EEST1/Entrenador_2023/shild_1/Documentacion/Captura desde 2023-02-04 18-30-01.png

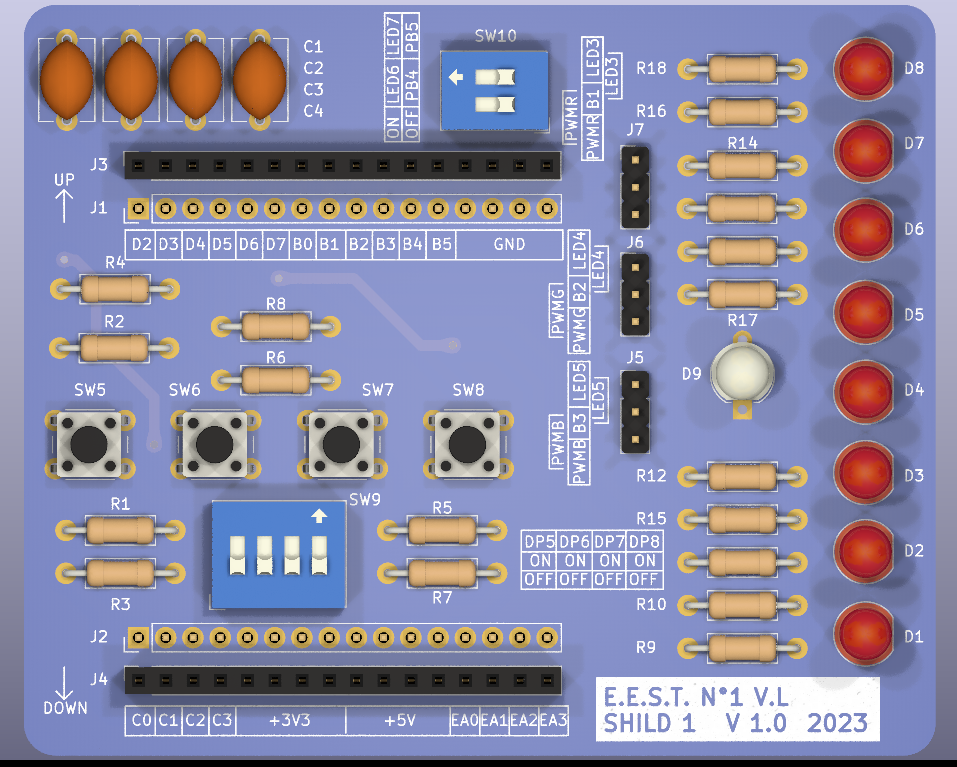
shild_1/Documentacion/Captura desde 2023-02-04 18-30-01.png
