EEST1/Entrenador_2023/placa_base/Placa_base_2layers/Documentacion/Captura desde 2023-01-20 19-26-29.png

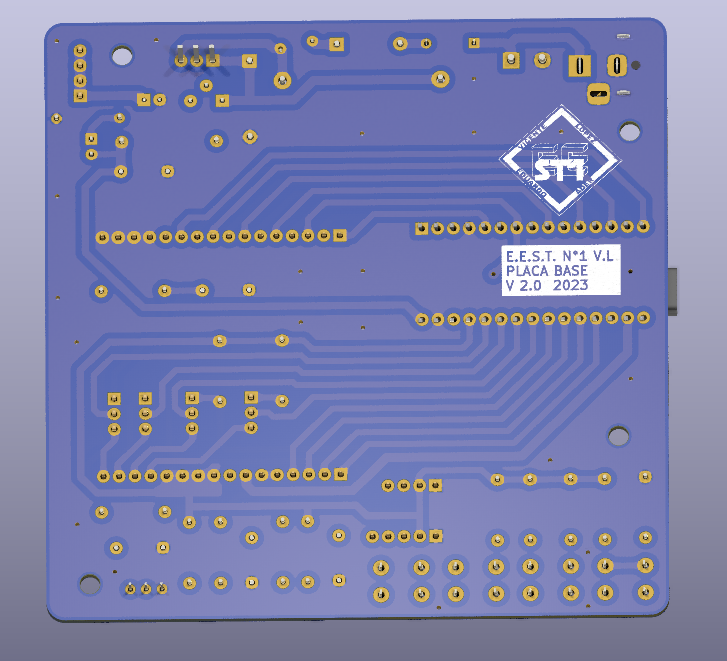
placa_base/Placa_base_2layers/Documentacion/Captura desde 2023-01-20 19-26-29.png
