EEST1/Entrenador_2023/shild_1/Documentacion/shild_1_buck.jpg

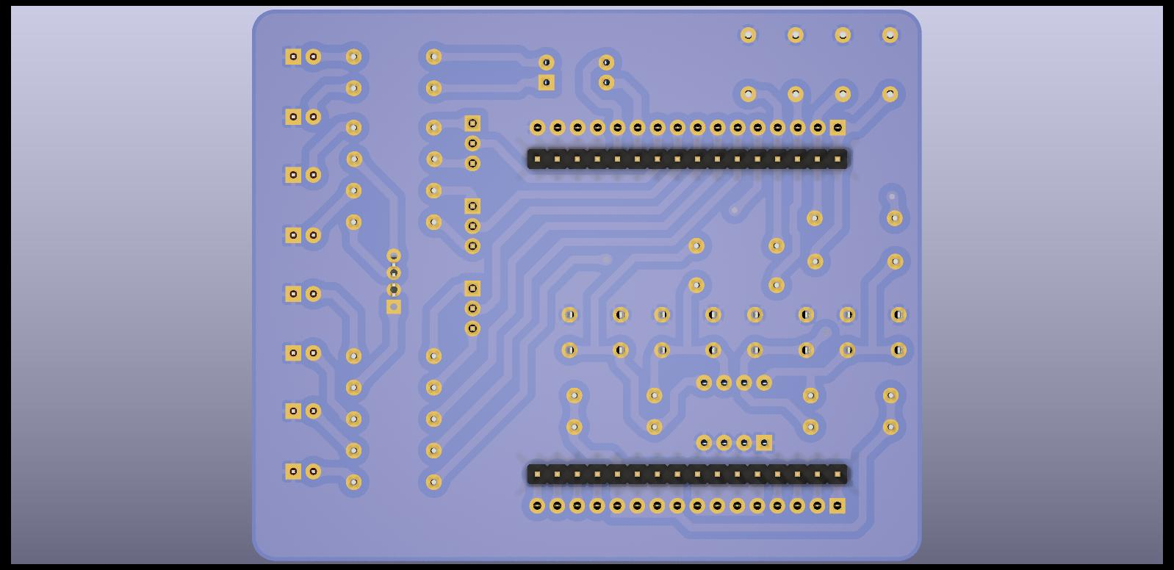
shild_1/Documentacion/shild_1_buck.jpg
