EEST1/Entrenador_2023/shild_1/fabrication/step/Placa_base.step

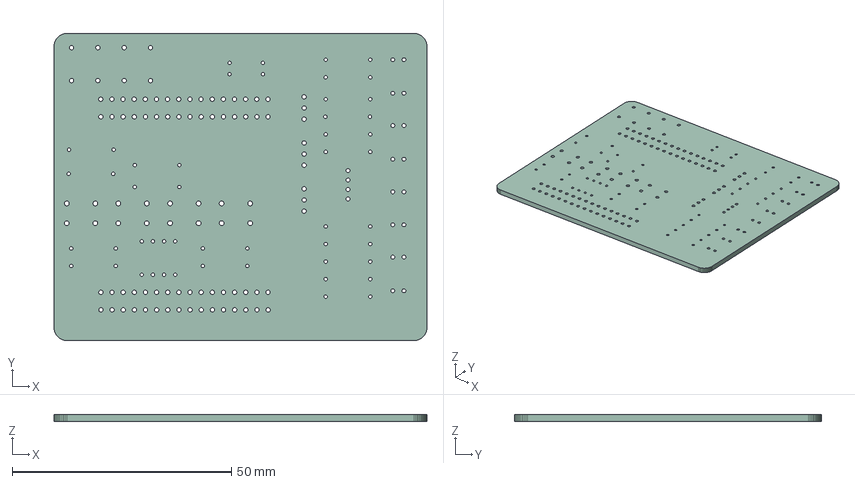
[picture p7: CAD file, 2023-05-10]
shild_1/fabrication/step/Placa_base.step
85.0 x 70.0 x 1.58 mm
