EEST1/Entrenador_2023/shild_1/Documentacion/shild_1.pdf

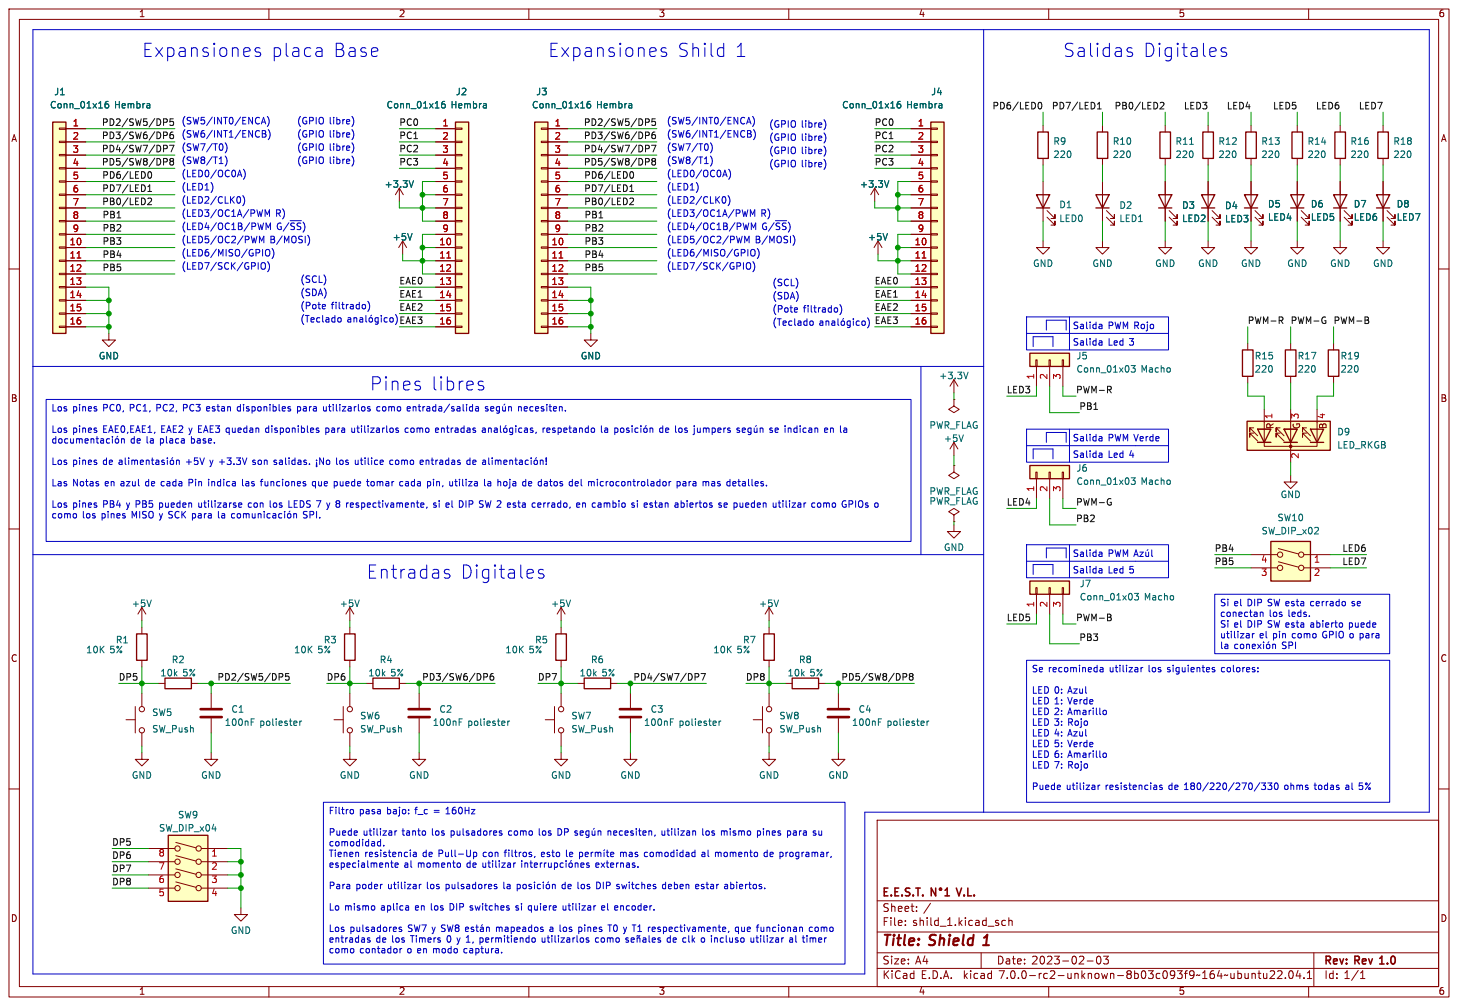
[picture p8: page 1]

conectan los leds. Si el DIP SW esta abierto puede

LED 2: Amarillo
LED 3: Rojo
LED 4: Azul LED 5: Verde
