EEST1/Entrenador_2023/shild_2/Documentacion/shild_2.pdf

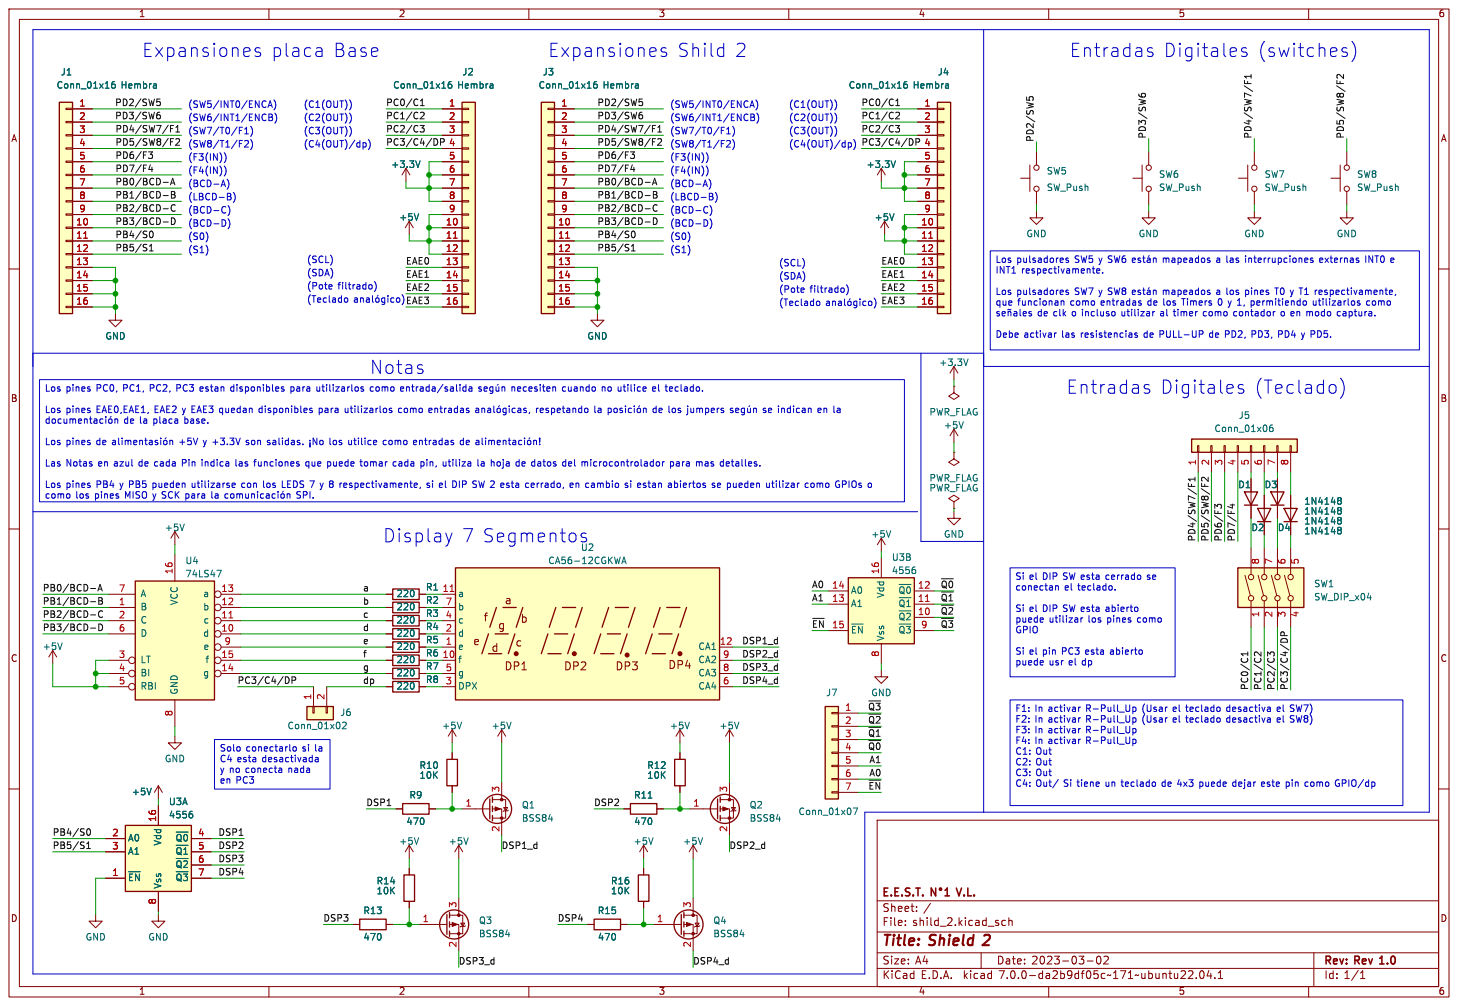
[picture p9: page 1]

conectan el teclado. Si el DIP SW esta abierto

Si el pin PC3 esta abierto
