EEST1/Entrenador_2023/placa_base/Placa_base_2layers/Documentacion/Placa_base.pdf

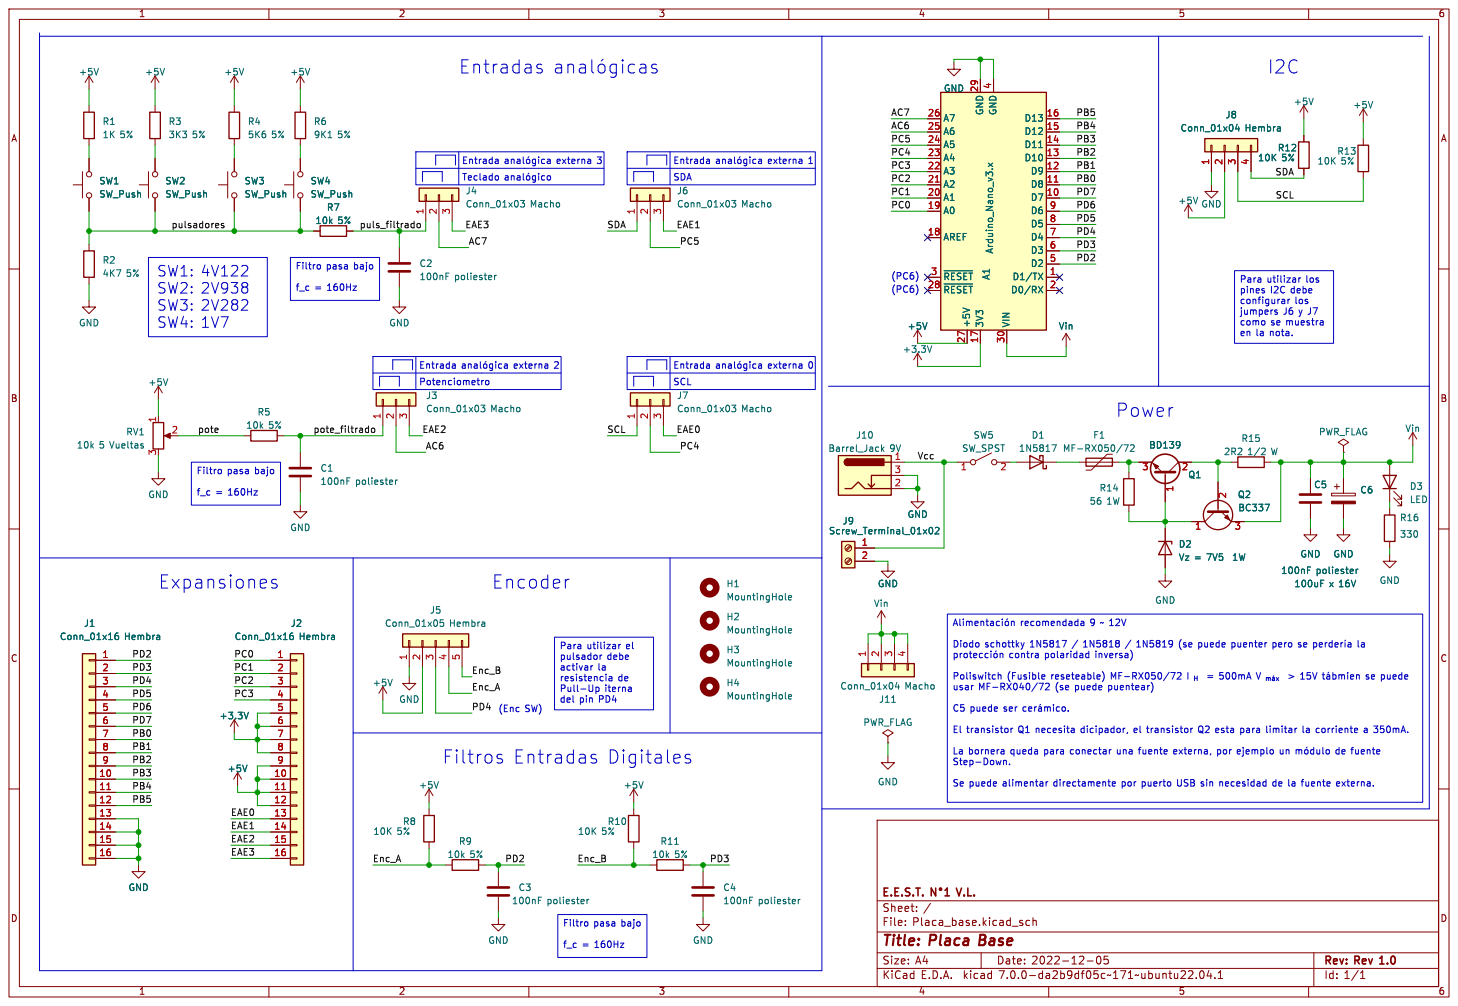
[picture p10: page 1]

Entrada þÿanalógica externa 3 Teclado þÿanalógico Entrada þÿanalógica externa 2 Entradas þÿanalógicas

Entrada þÿanalógica externa 1 SDA

Id: 1/1 Title: Placa Base
