EEST1/Entrenador_2023/placa_base/Draft1.asc

C1: cap; 100n
C2: cap; 100n
C3: cap; 100n
C4: cap; 100n
R1: res; 10k
R2: res; 10k
R4: res; 10k
R5: res; 10k
R6: res; 10k
R7: res; 10k
V1: voltage; ""; AC 1 0
V2: voltage; 5; Rser=0
V3: voltage; ""; AC 1 0
V4: voltage; ""; AC 1 0
V5: voltage; ""; AC 1 0
Named nets: 0, Vcc, out1, out2, out3, out4
.ac dec 1000 0.01 10Meg
