EEST1/Entrenador_2023/shild_2/Documentacion/pmos.asc

D1: LED; AOT-2015
M1: pmos; BSS84
R1: res; 470
R2: res; 10k
R3: res; 33
V1: voltage; PULSE(0 5 0 0.1 0.1 2 4 2)
V2: voltage; 5; Rser=0
Named nets: 0, Vcc
.tran 0 8 0 10m
