EEST1/Entrenador_2023/placa_base/Placa_base_2layers/Documentacion/fuebte.asc

D1: zener; EDZV7_5B
Q1: npn; BD139
Q2: npn; BC337-40
R1: res; 20
R2: res; 56
R3: res; 2.2
V2: voltage; SINE(10.5 1.5 1 0 0 0 6)
Named nets: 0
.tran 0 6 0 1m
