EEST1/Entrenador_2023/placa_base/Placa_base_2layers/Documentacion/fuebte_zener.asc

D1: zener; EDZV6_8B
R1: res; 20
R2: res; 6.2
V2: voltage; SINE(10.5 1.5 1 0 0 0 6)
Named nets: 0
.tran 0 6 0 1m
