EEST1/Entrenador_2023/placa_base/Placa_base_2layers/Placa_base.kicad_pcb

## KiCad design placa_base/Placa_base_2layers/Placa_base.kicad_pcb (2023-05-21)

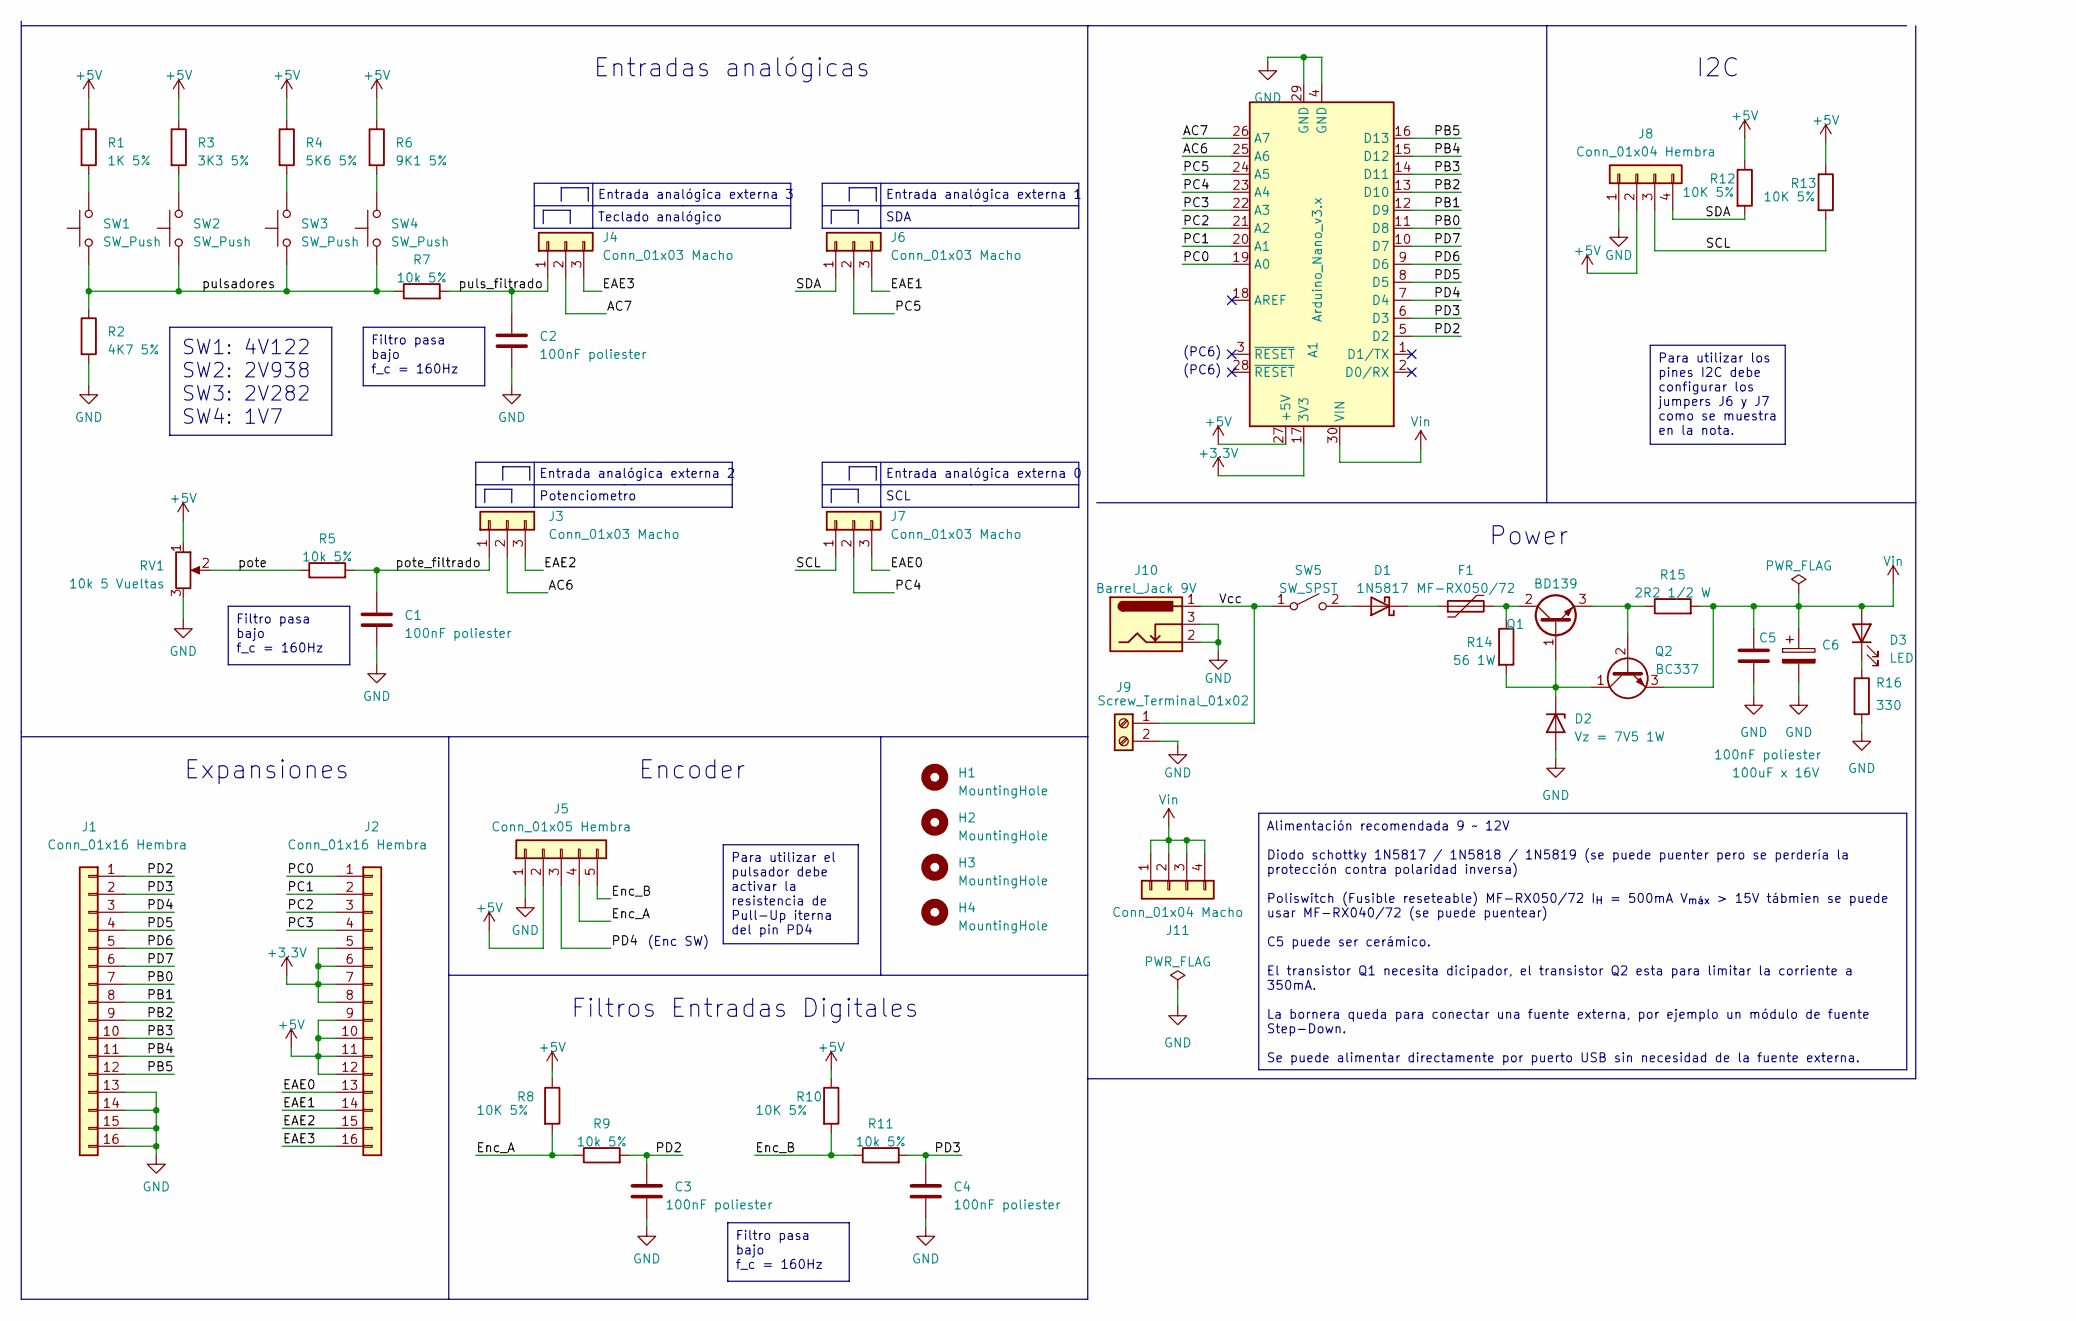
[picture p11: schematic Placa_base.kicad_sch, Placa Base]

Parts:
A1: Arduino_Nano_v3.x; Arduino_Nano
C1, C2, C3, C4, C5: 100nF poliester; C_Disc_D7.5mm_W5.0mm_P7.50mm
C6: 100uF x 16V; CP_Radial_D8.0mm_P3.50mm
D1: 1N5817; D_DO-41_SOD81_P10.16mm_Horizontal
D2: Vz = 7V5 1W; D_DO-41_SOD81_P12.70mm_Horizontal
D3: LED; LED_D3.0mm
F1: MF-RX050/72; Fuse_Bourns_MF-RHT050
H1, H2, H3, H4: MountingHole; MountingHole_3.2mm_M3
J1, J2: Conn_01x16 Hembra; PinSocket_1x16_P2.54mm_Vertical
J3, J4, J6, J7: Conn_01x03 Macho; PinHeader_1x03_P2.54mm_Vertical
J5: Conn_01x05 Hembra; PinSocket_1x05_P2.54mm_Vertical
J8: Conn_01x04 Hembra; PinSocket_1x04_P2.54mm_Vertical
J9: Screw_Terminal_01x02; TerminalBlock_Phoenix_PT-1,5-2-5.0-H_1x02_P5.00mm_Horizontal
J10: Barrel_Jack 9V; BarrelJack_Horizontal
J11: Conn_01x04 Macho; PinHeader_1x04_P2.54mm_Vertical
Q1: BD139; TO-126-3_Vertical
Q2: BC337; TO-92L_Wide
R1: 1K 5%; R_Axial_DIN0207_L6.3mm_D2.5mm_P10.16mm_Horizontal
R2: 4K7 5%; R_Axial_DIN0207_L6.3mm_D2.5mm_P10.16mm_Horizontal
R3: 3K3 5%; R_Axial_DIN0207_L6.3mm_D2.5mm_P10.16mm_Horizontal
R4: 5K6 5%; R_Axial_DIN0207_L6.3mm_D2.5mm_P10.16mm_Horizontal
R5, R7, R9, R11: 10k 5%; R_Axial_DIN0207_L6.3mm_D2.5mm_P10.16mm_Horizontal
R6: 9K1 5%; R_Axial_DIN0207_L6.3mm_D2.5mm_P10.16mm_Horizontal
R8, R10, R12, R13: 10K 5%; R_Axial_DIN0207_L6.3mm_D2.5mm_P10.16mm_Horizontal
R14: 56 1W; R_Axial_DIN0614_L14.3mm_D5.7mm_P25.40mm_Horizontal
R15: 2R2 1/2 W; R_Axial_DIN0309_L9.0mm_D3.2mm_P15.24mm_Horizontal
R16: 330; R_Axial_DIN0207_L6.3mm_D2.5mm_P10.16mm_Horizontal
RV1: 10k 5 Vueltas; Potentiometer_Bourns_3266Y_Vertical
SW1, SW2, SW3, SW4: SW_Push; SW_PUSH_6mm_H8mm
SW5: SW_SPST; SW_DIP_SPSTx01_Slide_9.78x4.72mm_W7.62mm_P2.54mm

Connections:
+3.3V: A1.17 (3V3), J2.5, J2.6, J2.7, J2.8
+5V: A1.27 (+5V), J2.9, J2.10, J2.11, J2.12, J5.2, J8.2, R1.1, R3.1, R4.1, R6.1, R8.1, R10.1, R12.1, R13.1, RV1.1
/AC6: A1.25 (A6), J3.2
/AC7: A1.26 (A7), J4.2
/EAE0: J2.13, J7.3
/EAE1: J2.14, J6.3
/EAE2: J2.15, J3.3
/EAE3: J2.16, J4.3
/Enc_A: J5.4, R8.2, R9.1
/Enc_B: J5.5, R10.2, R11.1
/PB0: A1.11 (D8), J1.7
/PB1: A1.12 (D9), J1.8
/PB2: A1.13 (D10), J1.9
/PB3: A1.14 (D11), J1.10
/PB4: A1.15 (D12), J1.11
/PB5: A1.16 (D13), J1.12
/PC0: A1.19 (A0), J2.1
/PC1: A1.20 (A1), J2.2
/PC2: A1.21 (A2), J2.3
/PC3: A1.22 (A3), J2.4
/PC4: A1.23 (A4), J7.2
/PC5: A1.24 (A5), J6.2
/PD2: A1.5 (D2), C3.1, J1.1, R9.2
/PD3: A1.6 (D3), C4.1, J1.2, R11.2
/PD4: A1.7 (D4), J1.3, J5.3
/PD5: A1.8 (D5), J1.4
/PD6: A1.9 (D6), J1.5
/PD7: A1.10 (D7), J1.6
/SCL: J7.1, J8.3, R13.2
/SDA: J6.1, J8.4, R12.2
/Vcc: J9.1, J10.1, SW5.1 (A)
/pote: R5.1, RV1.2
/pote_filtrado: C1.1, J3.1, R5.2
/puls_filtrado: C2.1, J4.1, R7.2
/pulsadores: R2.1, R7.1, SW1.1, SW2.1, SW3.1, SW4.1
GND: A1.4 (GND), A1.29 (GND), C1.2, C2.2, C3.2, C4.2, C5.2, C6.2, D2.2 (A), J1.13, J1.14, J1.15, J1.16, J5.1, J8.1, J9.2, J10.2, J10.3, R2.2, R16.2, RV1.3
unnamed: D1.2 (A), SW5.2 (B)
unnamed: D1.1 (K), F1.1
unnamed: D2.1 (K), Q1.1 (B), Q2.1 (C), R14.2
unnamed: D3.1 (K), R16.1
unnamed: F1.2, Q1.2 (C), R14.1
unnamed: Q1.3 (E), Q2.2 (B), R15.1
unnamed: R1.2, SW1.2
unnamed: R3.2, SW2.2
unnamed: R4.2, SW3.2
unnamed: R6.2, SW4.2
Vin: A1.30 (VIN), C5.1, C6.1, D3.2 (A), J11.1, J11.2, J11.3, J11.4, Q2.3 (E), R15.2

Notes on the sheet:
Filtro pasa bajo f_c = 160Hz
SW1: 4V122 SW2: 2V938 SW3: 2V282 SW4: 1V7
Alimentación recomendada 9 ~ 12V Diodo schottky 1N5817 / 1N5818 / 1N5819 (se puede puenter pero se perdería la protección contra polaridad inversa) Poliswitch (Fusible reseteable) MF-RX050/72 I_{H} = 500mA V_{máx} > 15V tábmien se puede usar MF-RX040/72 (se puede puentear) C5 puede ser cerámico. El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
Para utilizar el pulsador debe activar la resistencia de Pull-Up iterna del pin PD4
Para utilizar los pines I2C debe configurar los jumpers J6 y J7 como se muestra en la nota.
Entrada analógica externa 0
Entrada analógica externa 1
SCL
(PC6)
Encoder
Power
Entrada analógica externa 2
SDA
I2C
Filtros Entradas Digitales
Entrada analógica externa 3
Expansiones
Teclado analógico
(Enc SW)
Entradas analógicas
Potenciometro

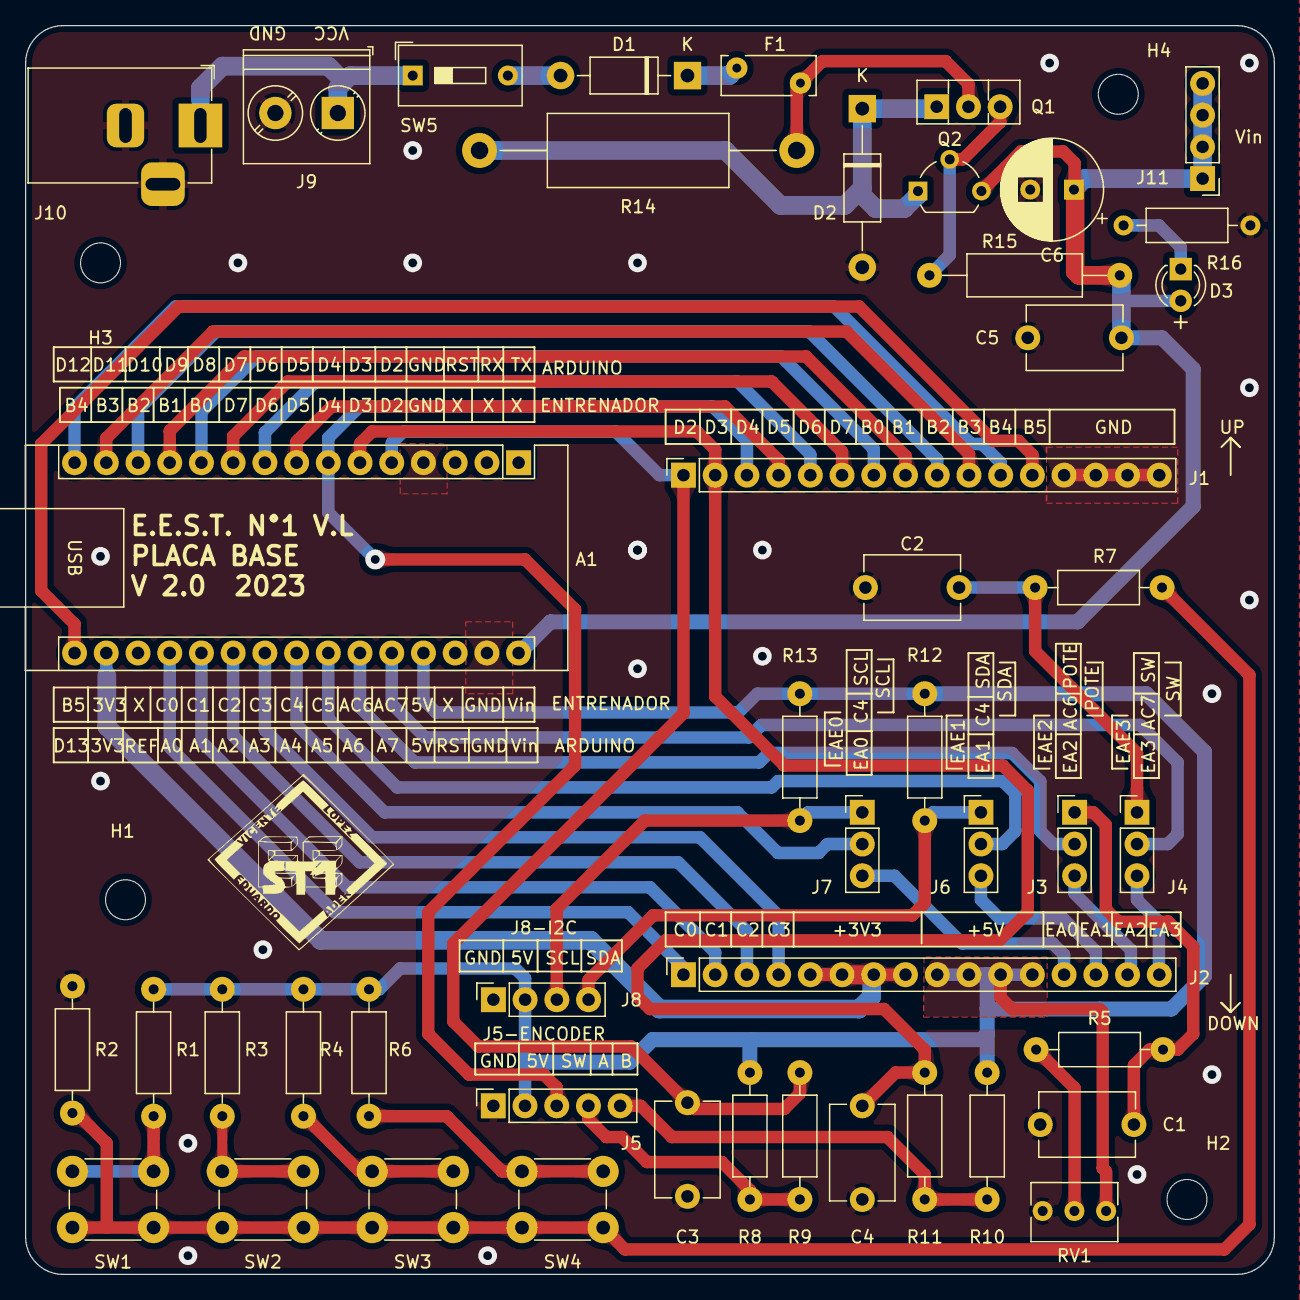
[picture p12: board Placa_base.kicad_pcb from above]

Board: 2 copper layers, 100.0 x 100.0 mm, 50 parts (0 on the bottom side), 47 nets.
