EEST1/Entrenador_2023/shild_2/shild_2.kicad_pcb

## KiCad design shild_2/shild_2.kicad_pcb (2023-05-10)

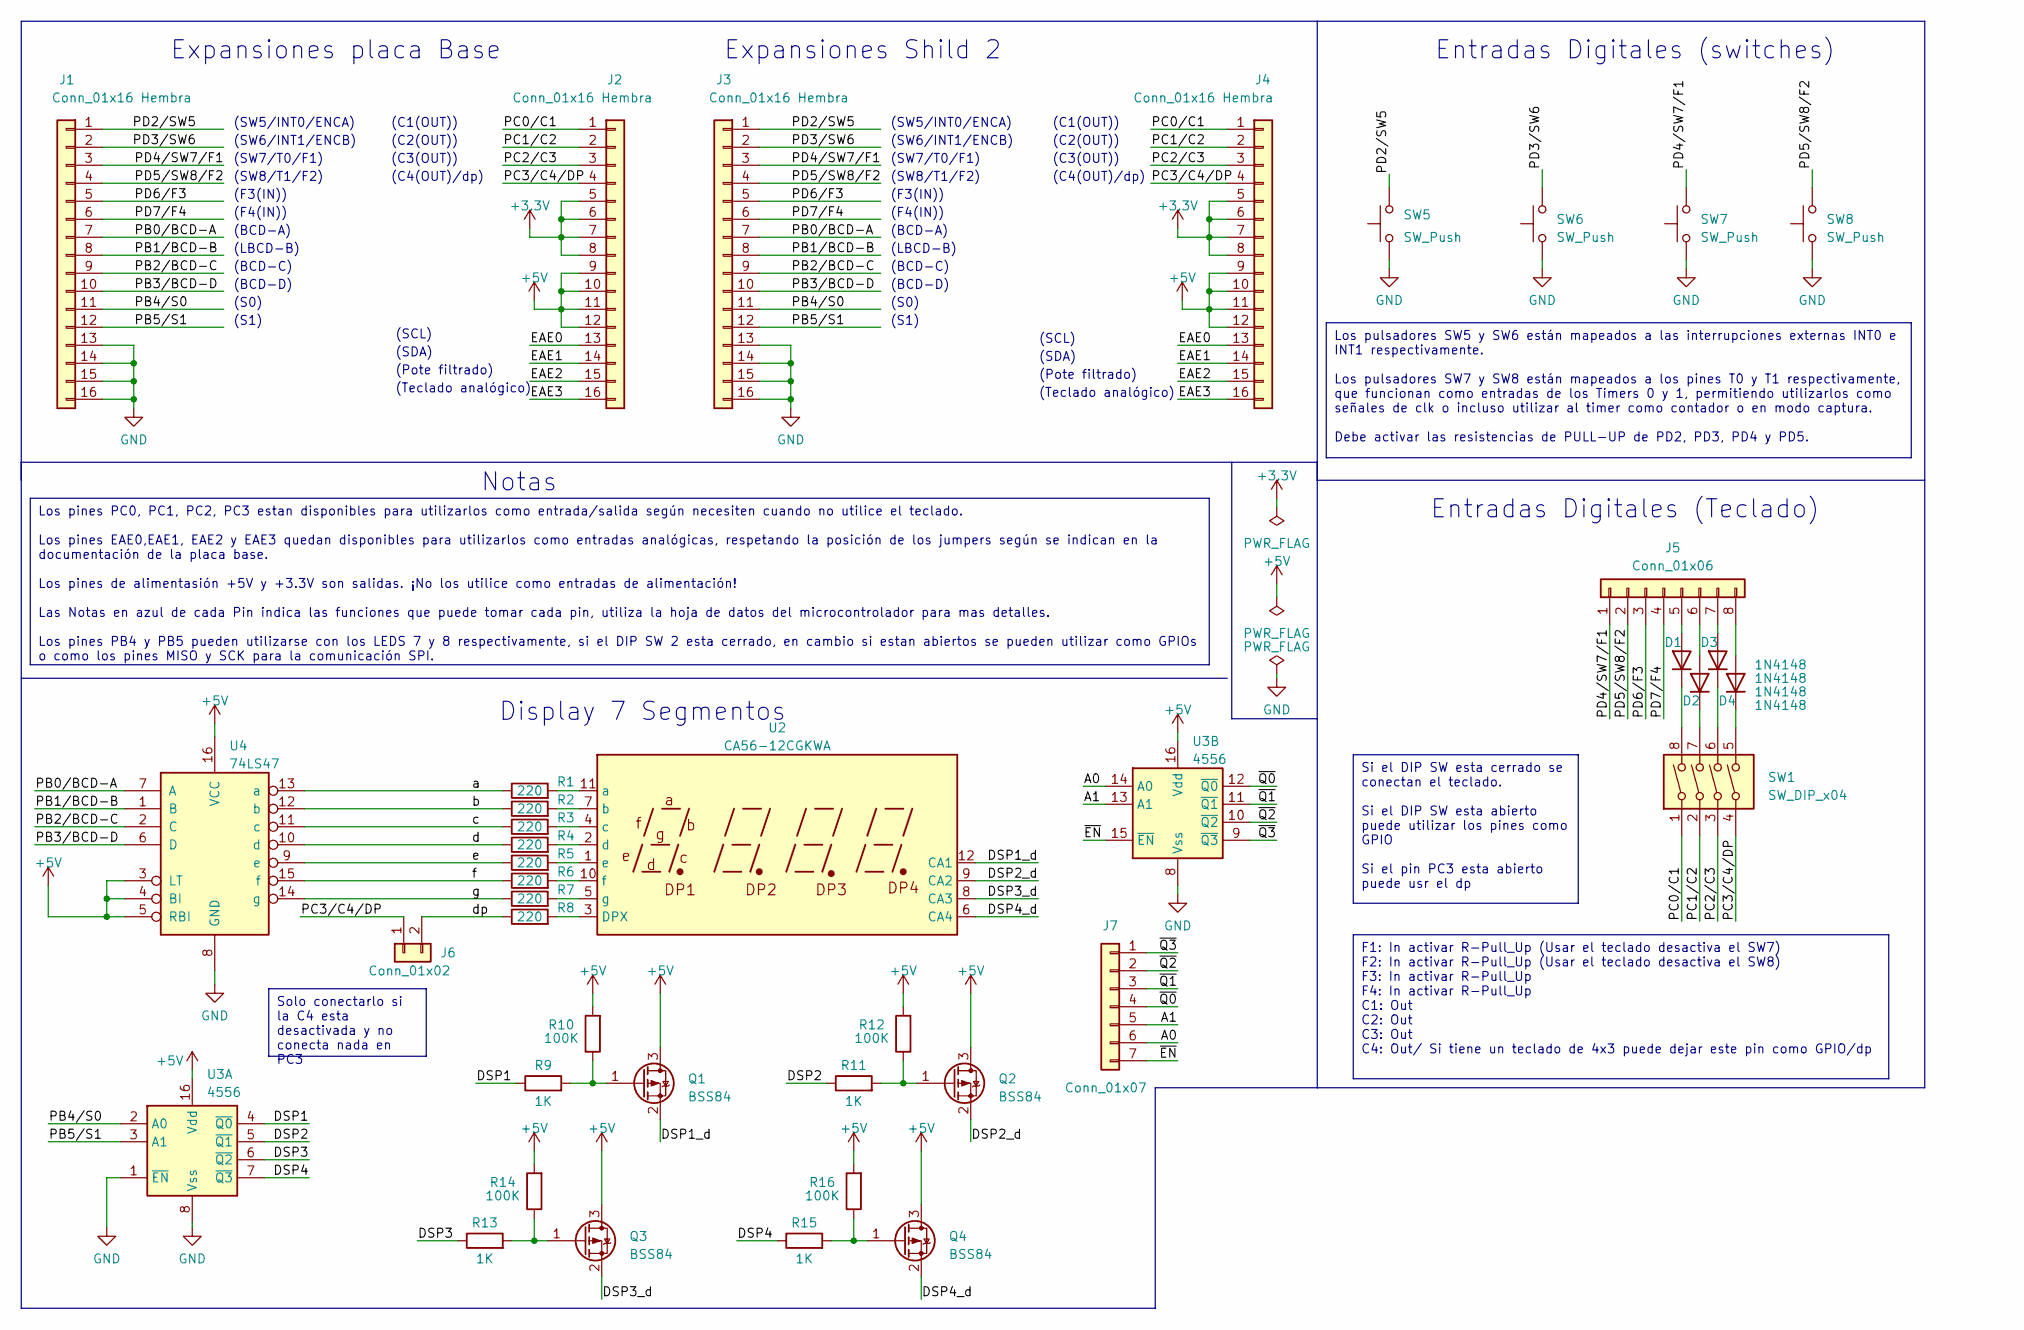
[picture p13: schematic shild_2.kicad_sch, Shield 2]

Parts:
D1, D2, D3, D4: 1N4148; D_DO-35_SOD27_P12.70mm_Horizontal
J1, J2: Conn_01x16 Hembra; PinHeader_1x16_P2.54mm_Vertical
J3, J4: Conn_01x16 Hembra; PinSocket_1x16_P2.54mm_Vertical
J5: Conn_01x06; PinHeader_1x08_P2.54mm_Vertical
J6: Conn_01x02; PinHeader_1x02_P2.54mm_Vertical
J7: Conn_01x07; PinHeader_1x07_P2.54mm_Vertical
Q1, Q2, Q3, Q4: BSS84; SOT-23
R1, R2, R3, R4, R5, R6, R7, R8: 220; R_Axial_DIN0309_L9.0mm_D3.2mm_P12.70mm_Horizontal
R9, R11, R13, R15: 1K; R_1206_3216Metric_Pad1.30x1.75mm_HandSolder
R10, R12, R14, R16: 100K; R_1206_3216Metric_Pad1.30x1.75mm_HandSolder
SW1: SW_DIP_x04; SW_DIP_SPSTx04_Slide_9.78x12.34mm_W7.62mm_P2.54mm
SW5, SW6, SW7, SW8: SW_Push; SW_PUSH_6mm_H8mm
U2: CA56-12CGKWA
U3: 4556; DIP-16_W7.62mm_LongPads
U4: 74LS47; DIP-16_W7.62mm_LongPads

Connections:
+3.3V: J2.5, J2.6, J2.7, J2.8, J4.5, J4.6, J4.7, J4.8
+5V: J2.9, J2.10, J2.11, J2.12, J4.9, J4.10, J4.11, J4.12, Q1.3 (D), Q2.3 (D), Q3.3 (D), Q4.3 (D), R10.2, R12.2, R14.2, R16.2, U3.16 (Vdd), U4.3 (LT), U4.4 (BI), U4.5 (RBI), U4.16 (VCC)
/A0: J7.6, U3.14 (A0)
/A1: J7.5, U3.13 (A1)
/DSP1: R9.1, U3.4 (~Q0)
/DSP1_d: Q1.2 (S), U2.12 (CA1)
/DSP2: R11.1, U3.5 (~Q1)
/DSP2_d: Q2.2 (S), U2.9 (CA2)
/DSP3: R13.1, U3.6 (~Q2)
/DSP3_d: Q3.2 (S), U2.8 (CA3)
/DSP4: R15.1, U3.7 (~Q3)
/DSP4_d: Q4.2 (S), U2.6 (CA4)
/EAE0: J2.13, J4.13
/EAE1: J2.14, J4.14
/EAE2: J2.15, J4.15
/EAE3: J2.16, J4.16
/PB0/BCD-A: J1.7, J3.7, U4.7 (A)
/PB1/BCD-B: J1.8, J3.8, U4.1 (B)
/PB2/BCD-C: J1.9, J3.9, U4.2 (C)
/PB3/BCD-D: J1.10, J3.10, U4.6 (D)
/PB4/S0: J1.11, J3.11, U3.2 (A0)
/PB5/S1: J1.12, J3.12, U3.3 (A1)
/PC0/C1: J2.1, J4.1, SW1.1
/PC1/C2: J2.2, J4.2, SW1.2
/PC2/C3: J2.3, J4.3, SW1.3
/PC3/C4/DP: J2.4, J4.4, J6.1, SW1.4
/PD2/SW5: J1.1, J3.1, SW5.2
/PD3/SW6: J1.2, J3.2, SW6.2
/PD4/SW7/F1: J1.3, J3.3, J5.1, SW7.2
/PD5/SW8/F2: J1.4, J3.4, J5.2, SW8.2
/PD6/F3: J1.5, J3.5, J5.3
/PD7/F4: J1.6, J3.6, J5.4
/a: R1.1, U4.13 (a)
/b: R2.1, U4.12 (b)
/c: R3.1, U4.11 (c)
/d: R4.1, U4.10 (d)
/dp: J6.2, R8.1
/e: R5.1, U4.9 (e)
/f: R6.1, U4.15 (f)
/g: R7.1, U4.14 (g)
/~EN: J7.7, U3.15 (~EN)
/~Q0: J7.4, U3.12 (~Q0)
/~Q1: J7.3, U3.11 (~Q1)
/~Q2: J7.2, U3.10 (~Q2)
/~Q3: J7.1, U3.9 (~Q3)
GND: J1.13, J1.14, J1.15, J1.16, J3.13, J3.14, J3.15, J3.16, SW5.1, SW6.1, SW7.1, SW8.1, U3.1 (~EN), U3.8 (Vss), U4.8 (GND)
unnamed: D1.2 (A), J5.5
unnamed: D1.1 (K), SW1.8
unnamed: D2.2 (A), J5.6
unnamed: D2.1 (K), SW1.7
unnamed: D3.2 (A), J5.7
unnamed: D3.1 (K), SW1.6
unnamed: D4.2 (A), J5.8
unnamed: D4.1 (K), SW1.5
unnamed: Q1.1 (G), R9.2, R10.1
unnamed: Q2.1 (G), R11.2, R12.1
unnamed: Q3.1 (G), R13.2, R14.1
unnamed: Q4.1 (G), R15.2, R16.1
unnamed: R8.2, U2.3 (DPX)
unnamed: R1.2, U2.11 (a)
unnamed: R2.2, U2.7 (b)
unnamed: R3.2, U2.4 (c)
unnamed: R4.2, U2.2 (d)
unnamed: R5.2, U2.1 (e)
unnamed: R6.2, U2.10 (f)
unnamed: R7.2, U2.5 (g)

Notes on the sheet:
Si el DIP SW esta cerrado se conectan el teclado. Si el DIP SW esta abierto puede utilizar los pines como GPIO Si el pin PC3 esta abierto puede usr el dp
Los pines PC0, PC1, PC2, PC3 estan disponibles para utilizarlos como entrada/salida según necesiten cuando no utilice el teclado. Los pines EAE0,EAE1, EAE2 y EAE3 quedan disponibles para utilizarlos como entradas analógicas, respetando la posición de los jumpers según se indican en la documentación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
Los pulsadores SW5 y SW6 están mapeados a las interrupciones externas INT0 e INT1 respectivamente. Los pulsadores SW7 y SW8 están mapeados a los pines T0 y T1 respectivamente, que funcionan como entradas de los Timers 0 y 1, permitiendo utilizarlos como señales de clk o incluso utilizar al timer co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
F1: In activar R-Pull_Up (Usar el teclado desactiva el SW7) F2: In activar R-Pull_Up (Usar el teclado desactiva el SW8) F3: In activar R-Pull_Up F4: In activar R-Pull_Up C1: Out C2: Out C3: Out C4: Out/ Si tiene un teclado de 4x3 puede dejar este pin como GPIO/dp
Solo conectarlo si la C4 esta desactivada y no conecta nada en PC3
(SW6/INT1/ENCB)
(F4(IN))
(C2(OUT))
(SW5/INT0/ENCA)
(SW7/T0/F1)
(SDA)
(Teclado analógico)
(SCL)
(S0)
(BCD-A)
(C3(OUT))
(LBCD-B)
Expansiones Shild 2
(F3(IN))
(Pote filtrado)
Entradas Digitales (Teclado)
(C4(OUT)/dp)
(SW8/T1/F2)
(C1(OUT))
Notas
Display 7 Segmentos
(S1)
Expansiones placa Base
Entradas Digitales (switches)
(BCD-C)
(BCD-D)

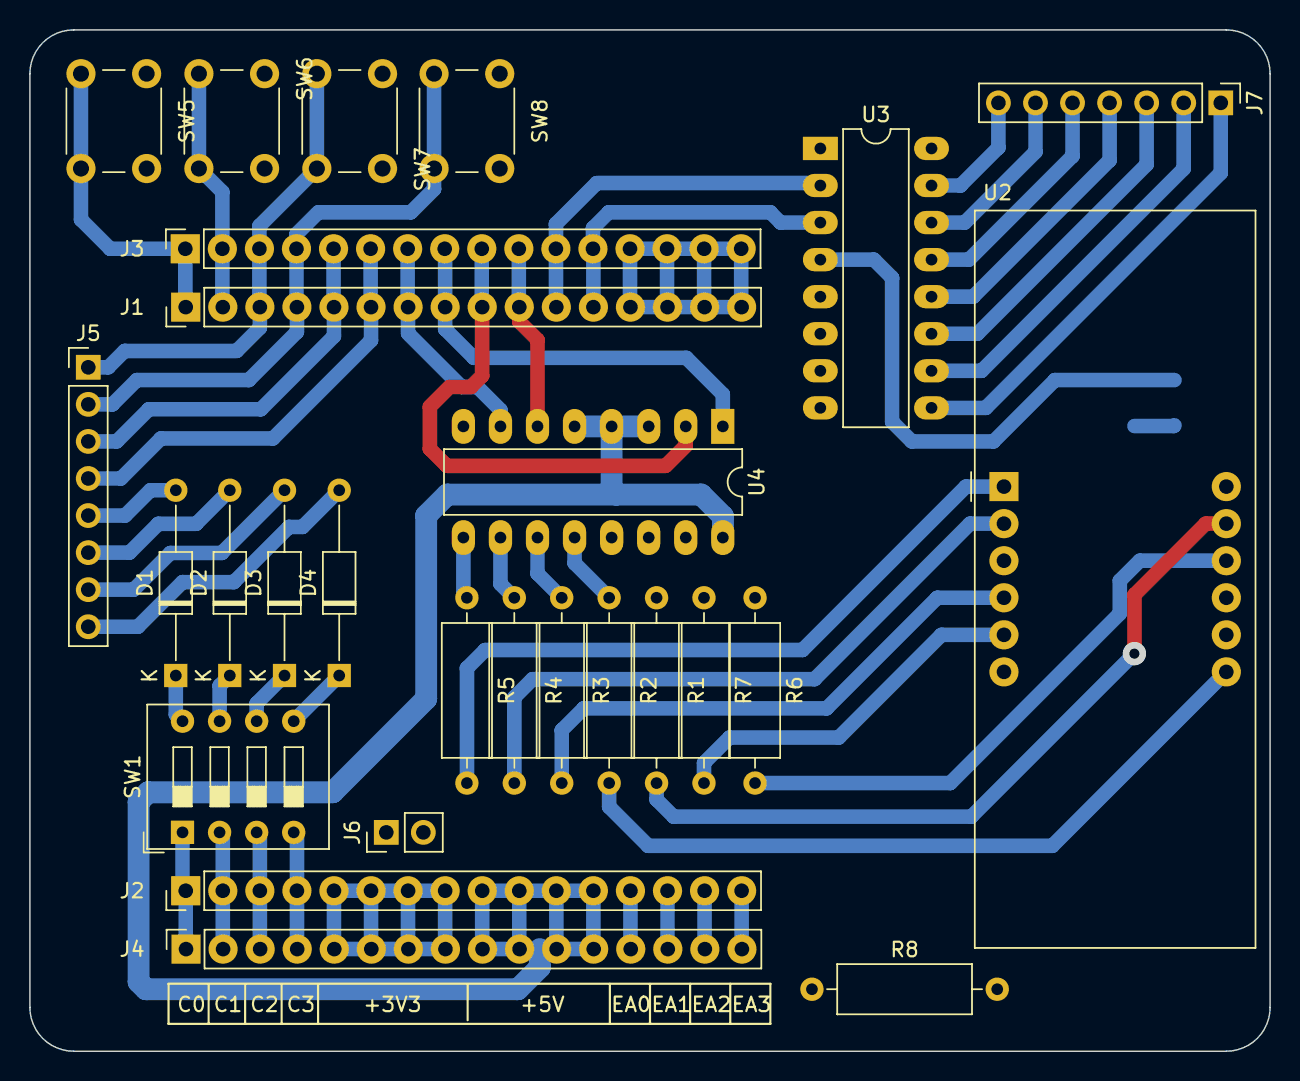
[picture p14: board shild_2.kicad_pcb from above]

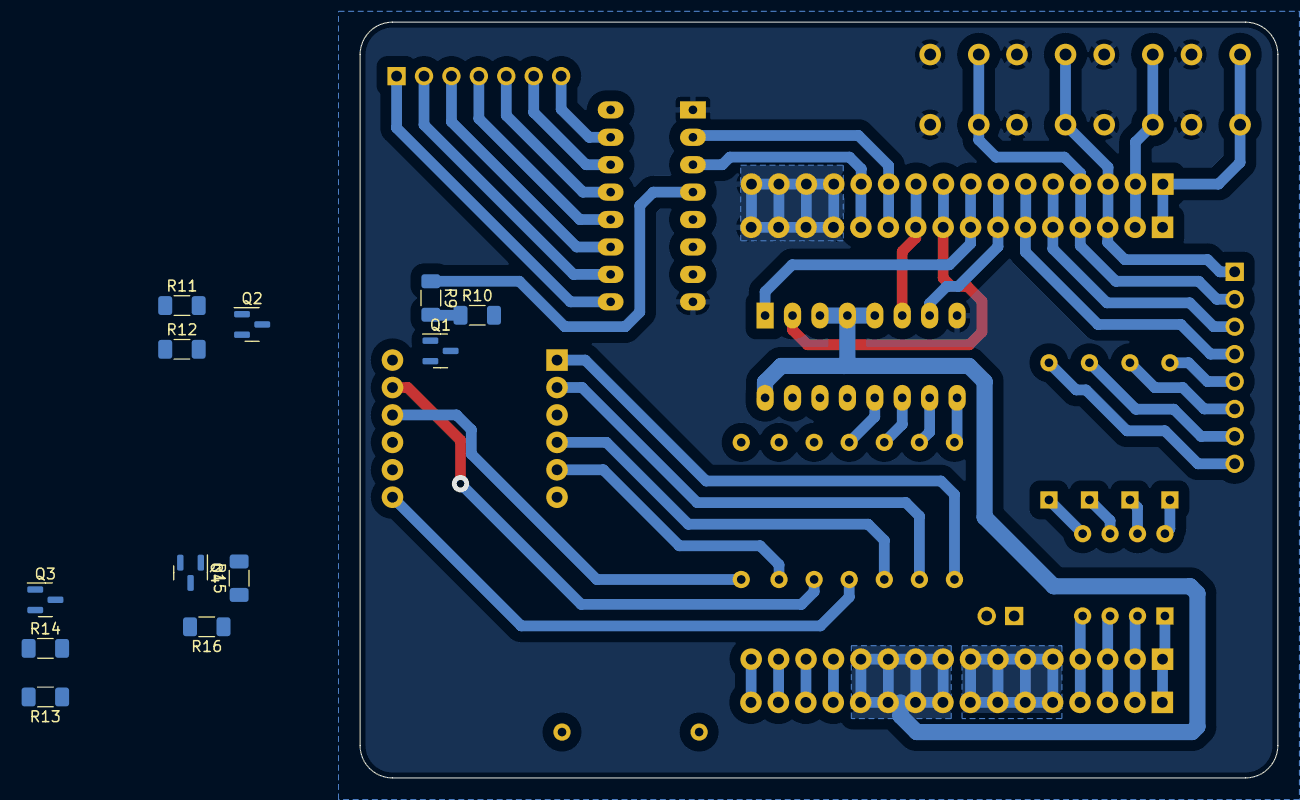
[picture p15: board shild_2.kicad_pcb from below]

Board: 2 copper layers, 85.0 x 70.0 mm, 39 parts (12 on the bottom side), 66 nets.
