EEST1/Entrenador_2023/shild_1/shild_1.kicad_pcb

## KiCad design shild_1/shild_1.kicad_pcb (2023-05-10)

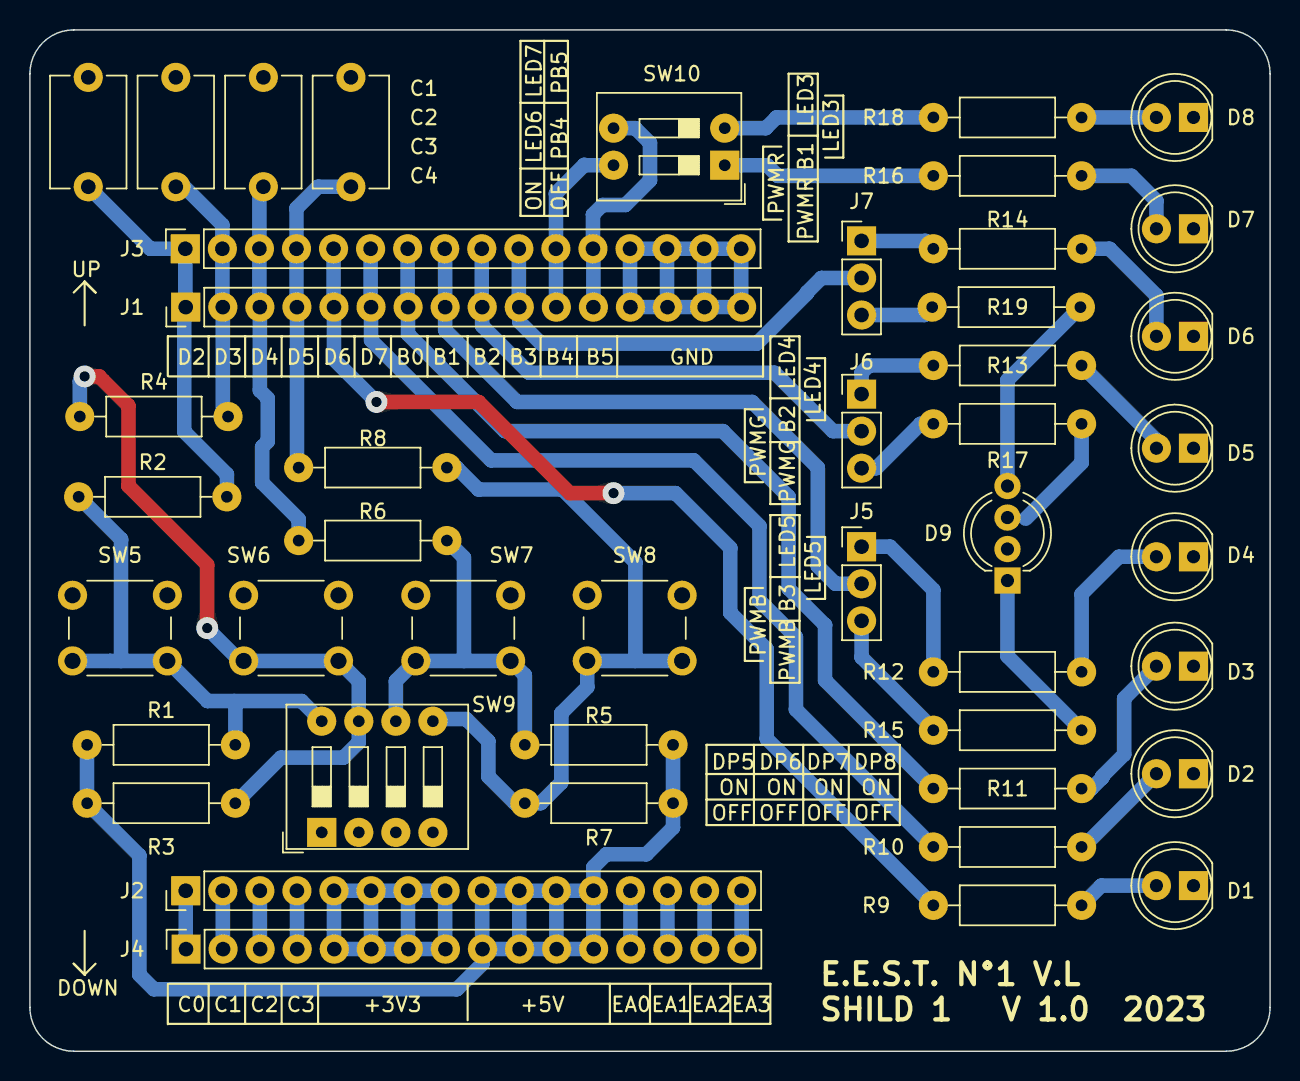
[picture p16: board shild_1.kicad_pcb from above]

Board: 2 copper layers, 85.0 x 70.0 mm, 45 parts (0 on the bottom side), 46 nets.

Parts:
C1, C2, C3, C4: 100nF poliester; C_Disc_D7.5mm_W5.0mm_P7.50mm
D1: LED0; LED_D5.0mm
D2: LED1; LED_D5.0mm
D3: LED2; LED_D5.0mm
D4: LED3; LED_D5.0mm
D5: LED4; LED_D5.0mm
D6: LED5; LED_D5.0mm
D7: LED6; LED_D5.0mm
D8: LED7; LED_D5.0mm
D9: LED_RKGB; LED_D5.0mm-4_RGB_Wide_Pins
J1, J2: Conn_01x16 Hembra; PinHeader_1x16_P2.54mm_Vertical
J3, J4: Conn_01x16 Hembra; PinSocket_1x16_P2.54mm_Vertical
J5, J6, J7: Conn_01x03 Macho; PinHeader_1x03_P2.54mm_Vertical
R1, R3, R5, R7: 10K 5%; R_Axial_DIN0207_L6.3mm_D2.5mm_P10.16mm_Horizontal
R2, R4, R6, R8: 10k 5%; R_Axial_DIN0207_L6.3mm_D2.5mm_P10.16mm_Horizontal
R9, R10, R11, R12, R13, R14, R15, R16, R17, R18, R19: 220; R_Axial_DIN0207_L6.3mm_D2.5mm_P10.16mm_Horizontal
SW5, SW6, SW7, SW8: SW_Push; SW_PUSH_6mm_H8mm
SW9: SW_DIP_x04; SW_DIP_SPSTx04_Slide_9.78x12.34mm_W7.62mm_P2.54mm
SW10: SW_DIP_x02; SW_DIP_SPSTx02_Slide_9.78x7.26mm_W7.62mm_P2.54mm

Connections:
+3.3V: J2.5, J2.6, J2.7, J2.8, J4.5, J4.6, J4.7, J4.8
+5V: J2.9, J2.10, J2.11, J2.12, J4.9, J4.10, J4.11, J4.12, R1.1, R3.1, R5.1, R7.1
/DP5: R1.2, R2.1, SW5.2, SW9.8
/DP6: R3.2, R4.1, SW6.2, SW9.7
/DP7: R5.2, R6.1, SW7.2, SW9.6
/DP8: R7.2, R8.1, SW8.2, SW9.5
/EAE0: J2.13, J4.13
/EAE1: J2.14, J4.14
/EAE2: J2.15, J4.15
/EAE3: J2.16, J4.16
/LED3: J5.1, R12.1
/LED4: J6.1, R13.1
/LED5: J7.1, R14.1
/LED6: R16.1, SW10.1
/LED7: R18.1, SW10.2
/PB0/LED2: J1.7, J3.7, R11.1
/PB1: J1.8, J3.8, J5.2
/PB2: J1.9, J3.9, J6.2
/PB3: J1.10, J3.10, J7.2
/PB4: J1.11, J3.11, SW10.4
/PB5: J1.12, J3.12, SW10.3
/PC0: J2.1, J4.1
/PC1: J2.2, J4.2
/PC2: J2.3, J4.3
/PC3: J2.4, J4.4
/PD2/SW5/DP5: C1.1, J1.1, J3.1, R2.2
/PD3/SW6/DP6: C2.1, J1.2, J3.2, R4.2
/PD4/SW7/DP7: C3.1, J1.3, J3.3, R6.2
/PD5/SW8/DP8: C4.1, J1.4, J3.4, R8.2
/PD6/LED0: J1.5, J3.5, R9.1
/PD7/LED1: J1.6, J3.6, R10.1
/PWM-B: J7.3, R19.1
/PWM-G: J6.3, R17.1
/PWM-R: J5.3, R15.1
GND: C1.2, C2.2, C3.2, C4.2, D1.1 (K), D2.1 (K), D3.1 (K), D4.1 (K), D5.1 (K), D6.1 (K), D7.1 (K), D8.1 (K), D9.2 (K), J1.13, J1.14, J1.15, J1.16, J3.13, J3.14, J3.15, J3.16, SW5.1, SW6.1, SW7.1, SW8.1, SW9.1, SW9.2, SW9.3, SW9.4
unnamed: D1.2 (A), R9.2
unnamed: D2.2 (A), R10.2
unnamed: D3.2 (A), R11.2
unnamed: D4.2 (A), R12.2
unnamed: D5.2 (A), R13.2
unnamed: D6.2 (A), R14.2
unnamed: D7.2 (A), R16.2
unnamed: D8.2 (A), R18.2
unnamed: D9.4 (BA), R19.2
unnamed: D9.3 (GA), R17.2
unnamed: D9.1 (RA), R15.2
