EEST1/Entrenador_2023/(commit log)

2023-05-10 Changes to be committed: new file: desktop.ini new file: placa_base/Draft1.asc new file: placa_base/Placa_base_2layers/#auto_saved_files# new file: placa_base/Placa_base_2layers/Documentacion/Captura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
    [Placa_base-B_Cu.gbr, Placa_base-B_Mask.gbr, Placa_base-B_Paste.gbr, Placa_base-B_Silkscreen.gbr, Placa_base-Edge_Cuts.gbr, Placa_base-F_Cu.gbr, Placa_base-F_Mask.gbr, Placa_base-F_Paste.gbr]
2023-05-10 Changes to be committed: new file: placa_base/Placa_base_2layers/fabrication/gerbers/10Mayo2023/Placa_base-B_Cu.gbr new file: placa_base/Placa_base_2layers/fabrication/gerbers/10Mayo2023/Placa_base-E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
    [Placa_base-B_Cu.gbr, Placa_base-Edge_Cuts.gbr, Placa_base-F_Cu.gbr, Placa_base-NPTH.drl, Placa_base-PTH.drl, Placa_base-job.gbrjob]
2023-05-21 Please enter the commit message for your changes. Lines starting with '#' will be ignored, and an empty message aborts the commit.
    On branch master
    Your branch is up to date with 'Entrenador2023/master'.
    Changes to be committed:
    modified: desktop.ini
    deleted: placa_base/Placa_base_2layers/#auto_saved_files#
    modified: placa_base/Placa_base_2layers/Documentacion/datasheets/desktop.ini
    modified: placa_base/Placa_base_2layers/Documentacion/desktop.ini
    deleted: placa_base/Placa_base_2layers/Placa_base-backups/Placa_base-2023-01-19_191132.zip
    deleted: placa_base/Placa_base_2layers/Placa_base-backups/Placa_base-2023-01-19_195627.zip
    deleted: placa_base/Placa_base_2laye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
    [Placa_base.kicad_pcb, Placa_base.kicad_sch]
